zyf-14/LITS-simulation-project/README.md

# LITS Simulation Project




A low-inertia transit system (LITS) built on an autonomous RC car platform. The car follows a black line on the ground using IR sensors, handles intersection triggers, and can be driven manually via keyboard. This repo contains the Raspberry Pi control software, 3D CAD models, and a PC-side video analysis tool.

> **Current status:** the active RC car implementation is in [`rc_car/`](rc_car/) (`track_run.py` + `cycle_server.py`, installed as a systemd service) and the active boom-gate firmware is in [`setup/`](setup/). `src/`, `tools/`, and `simulation/` below are an earlier iteration of the same car, kept for reference — see `archive/` for older experiments. For system architecture, network layout, and the full operating procedure for the LPR car-park demo this project now drives, see the handover documentation supplied alongside this repo.

---

## Folder Structure

```
LITS-simulation-project/
├── src/                  # Raspberry Pi runtime code
│   ├── main.py           # Entry point — runs the line-following loop
│   ├── motor.py          # Servo and DC motor control (GPIO + pigpio)
│   ├── sensor.py         # IR sensor reader (GPIO)
│   ├── flow.py           # Intersection / trigger phase handler
│   ├── config.py         # Vision constants and image processing helpers
│   ├── line_following.py # Frame-level line detection logic
│   ├── camera.py         # Camera interface stub
│   └── picam_trigger.py  # PiCamera2 black-line trigger detector
│
├── tools/                # Standalone calibration and debug utilities
│   ├── calibrate_servo.py    # Interactive servo angle calibration (o/l/r/q keys)
│   ├── test_servo_center.py  # Holds servo at centre position for testing
│   └── manual_drive.py       # WASD keyboard control of motor and servo
│
├── simulation/           # PC-side analysis (no Pi hardware required)
│   └── virtual_test.py   # Replay a recorded video and visualise line-following decisions
│
├── hardware/
│   └── cad/
│       ├── RC Car/           # STL files for chassis, mounts, and panels
│       ├── Boom gate/        # STL files for the boom gate assembly
│       └── Custom Motor driver PCB schematics.pdf
│
├── setup/                # ESP32 firmware for the boom gate (PlatformIO project)
│   ├── src/main.cpp          # Main firmware — FreeRTOS tasks, servo, ultrasonic, Wi-Fi
│   ├── include/
│   │   ├── config.example.h  # Credential template — copy to config.h and fill in
│   │   └── config.h          # Your credentials (gitignored, never committed)
│   └── platformio.ini        # PlatformIO board and library config
│
├── archive/              # Earlier experimental variants (kept for reference)
│
├── requirements.txt
└── .gitignore
```

---

## Hardware

### RC Car
| Component | Detail |
|---|---|
| Platform | RC car chassis with custom 3D-printed body |
| Controller | Raspberry Pi (any model with GPIO) |
| Steering | SG90 servo on GPIO 18 |
| Drive motor | DC motor via L298N-style driver (BIN1=GPIO27, BIN2=GPIO17) |
| Line sensors | 2× IR sensors (LEFT=GPIO22, RIGHT=GPIO25) |
| Camera | Raspberry Pi Camera Module (PiCamera2) |

### Boom Gate
| Component | Detail |
|---|---|
| Controller | ESP32 (DOIT DevKit V1) |
| Gate servo | SG90 on GPIO 13 |
| Distance sensors | 2× HC-SR04 ultrasonic (Sensor 1: TRIG=2, ECHO=5 / Sensor 2: TRIG=18, ECHO=15) |
| Status LED | GPIO 4 |

3D CAD models are in `hardware/cad/`. The full OnShape design is at:
[View OnShape model](https://cad.onshape.com/documents/3a9c78263ff22dc350c29a50/w/96404cf1ed0ead9f22eaefd4/e/8b10ad415629b44db3a26b1b)

---

## Software Setup

### 1. Install dependencies (on the Raspberry Pi)

```bash
pip install -r requirements.txt
sudo pigpiod        # start the pigpio daemon (required at boot)
```

### 2. Run the line follower

```bash
cd src
python main.py
```

Press `Ctrl+C` to stop. GPIO is cleaned up automatically.

### 3. Manual drive (WASD keyboard)

```bash
cd tools
python manual_drive.py
# W = forward, A = left, D = right, S = stop, Ctrl+C = quit
```

### 4. Servo calibration

```bash
cd tools
python calibrate_servo.py
# o = centre, l = left, r = right, q = quit
```

---

## Boom Gate Firmware Setup

The boom gate runs on an ESP32 and is flashed using **PlatformIO** (a VS Code extension — no separate Arduino IDE needed).

### 1. Install PlatformIO

1. Install [VS Code](https://code.visualstudio.com/)
2. Open the Extensions panel (`Ctrl+Shift+X`) and search for **PlatformIO IDE**
3. Install it and restart VS Code

### 2. Configure credentials

```bash
cp setup/include/config.example.h setup/include/config.h
```

Open `config.h` and fill in your Wi-Fi SSID, password, and Pi server IP. This file is gitignored and will never be committed.

### 3. Flash to the ESP32

1. Open the `setup/` folder in VS Code — PlatformIO will detect `platformio.ini` automatically
2. Connect the ESP32 via USB
3. Click the **Upload** button (→ arrow) in the PlatformIO toolbar, or run:

```bash
cd setup
pio run --target upload
```

### 4. Monitor serial output

```bash
cd setup
pio device monitor
```

Or connect via Telnet on port 23 from any device on the same network:
```bash
telnet <ESP32_IP> 23
```

---

## Simulation (PC only)

Replay a recorded run and visualise line-detection decisions frame by frame:

```bash
cd simulation
python virtual_test.py /path/to/recording.mp4
```

Press `q` to quit.

---

## How It Works

1. `sensor.py` reads two IR sensors — each returns `HIGH` on black, `LOW` on white.
2. `main.py` steers left or right depending on which sensor sees the line.
3. When **both** sensors see black (an intersection marker), `flow.py` runs a timed stop-and-turn phase sequence.
4. `motor.py` drives the DC motor with PWM bursts and controls the servo via pigpio pulse widths.

---

## License

MIT — see [LICENSE](LICENSE) for details.
