zyf-14/LITS-simulation-project/hardware/cad/RC Car/RC side car panels.stl

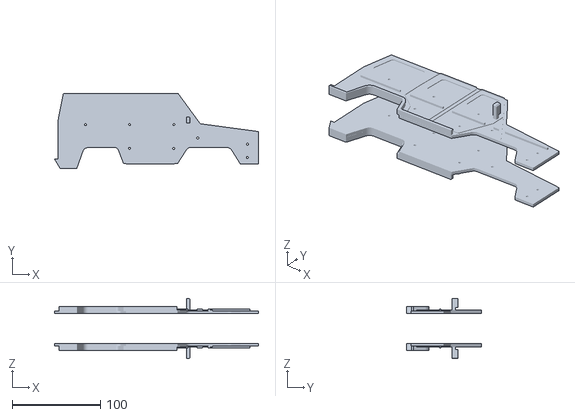
[picture p1: CAD file, 2026-04-12]
hardware/cad/RC Car/RC side car panels.stl
230.8 x 84.5 x 68.0
