zyf-14/LITS-simulation-project/hardware/cad/RC Car/RC body frames.stl

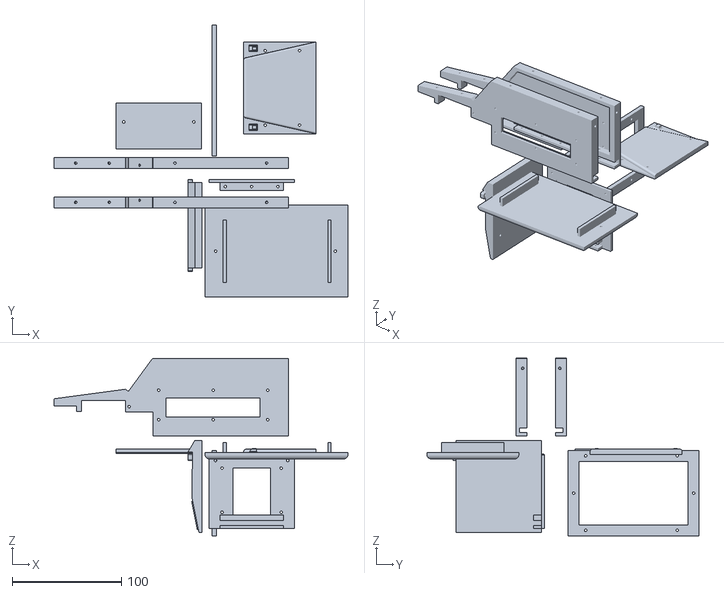
[picture p2: CAD file, 2026-04-12]
hardware/cad/RC Car/RC body frames.stl
269.5 x 249.5 x 162.7
