zyf-14/LITS-simulation-project/hardware/cad/RC Car/Pi camera holder + Grill cover.stl

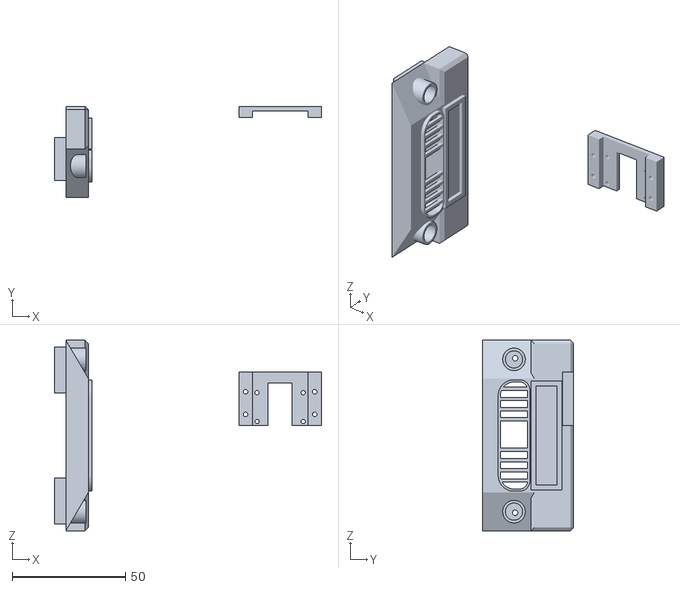
[picture p3: CAD file, 2026-04-12]
hardware/cad/RC Car/Pi camera holder + Grill cover.stl
118.0 x 40.4 x 84.3
