zyf-14/LITS-simulation-project/hardware/cad/RC Car/RC car base.stl

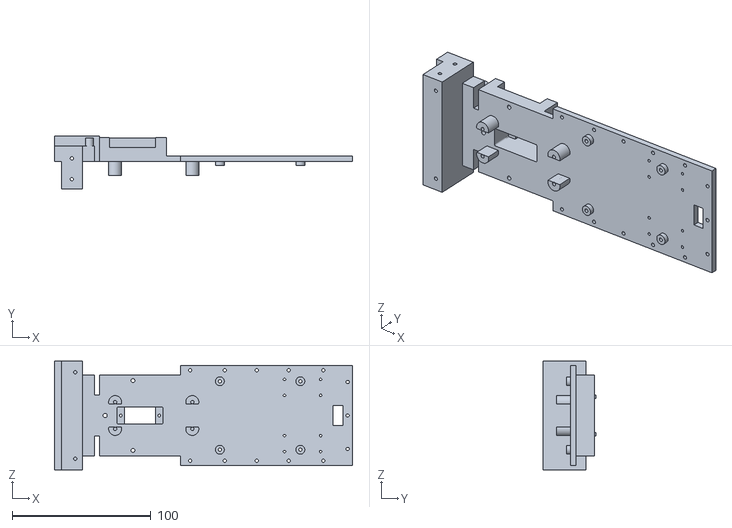
[picture p4: CAD file, 2026-04-12]
hardware/cad/RC Car/RC car base.stl
214.7 x 38.5 x 78.2
