zyf-14/LITS-simulation-project/hardware/cad/RC Car/Steering mechanism.stl

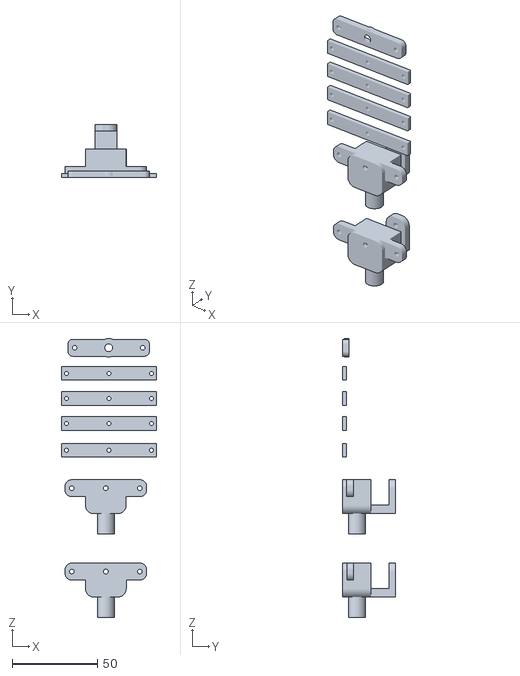
[picture p5: CAD file, 2026-04-12]
hardware/cad/RC Car/Steering mechanism.stl
56.1 x 31.4 x 164.0
