zyf-14/LITS-simulation-project/hardware/cad/RC Car/Arduino motor holder.stl

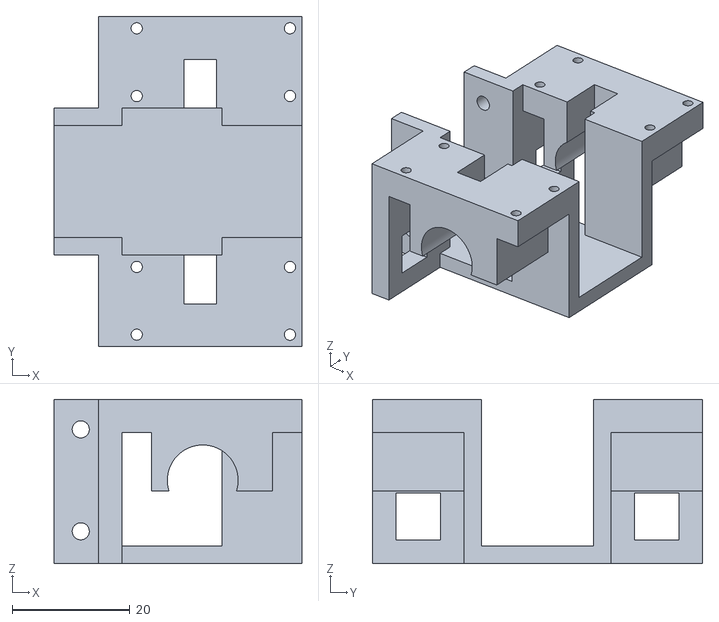
[picture p6: CAD file, 2026-04-12]
hardware/cad/RC Car/Arduino motor holder.stl
42.0 x 56.0 x 27.9
