zyf-14/LITS-simulation-project/hardware/cad/Custom Motor driver PCB schematics.pdf

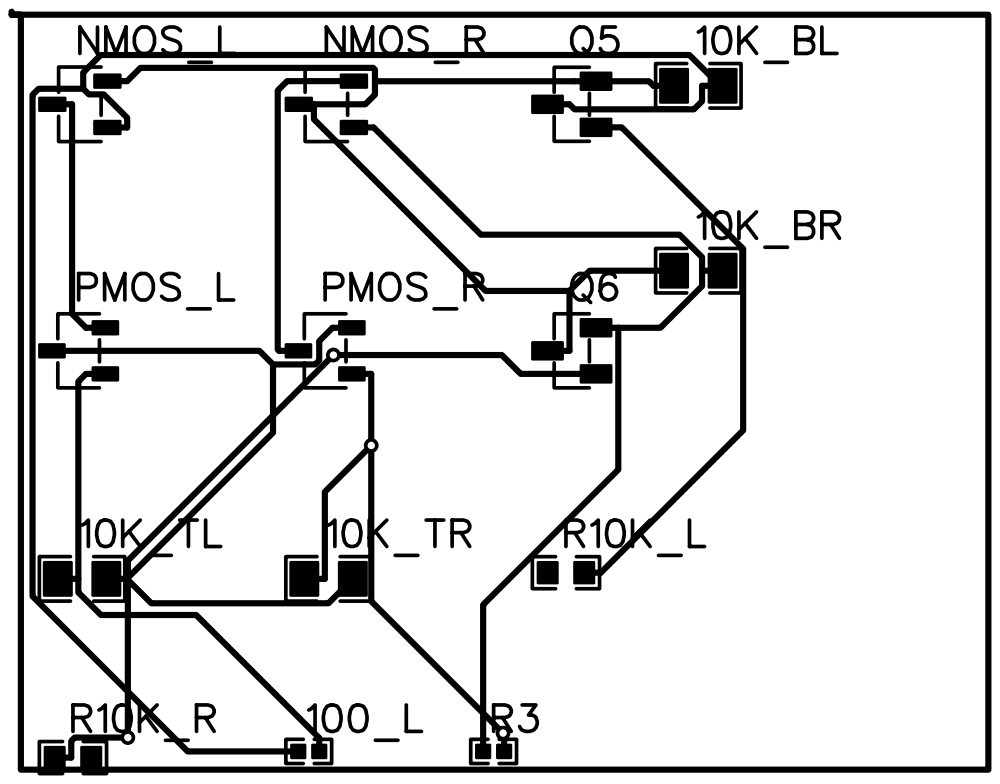
[picture p7: page 1]
