zyf-14/LITS-simulation-project/rc_car/camera.py

# === camera.py ===

# Dummy function — always returns True for testing
def sees_black_object():
    # Replace this with actual OpenCV logic later
    return False  # Return True to simulate obstacle, False to simulate clear path
