zyf-14/LITS-simulation-project/setup/include/config.example.h

#ifndef CONFIG_H
#define CONFIG_H

// Copy this file to config.h (gitignored) and fill in real values.
// config.h is never committed - see .gitignore.

constexpr char WIFI_SSID[]     = "your-ssid";
constexpr char WIFI_PASSWORD[] = "your-password";

#endif
