zyf-14/LITS-simulation-project/(commit log)

2025-07-08 Drawing a vertical line across the center of every frame that acts as a centerpoint
2026-04-12 Updated CAD link
2026-04-12 Uploaded schematic for custom motor driver
2026-04-12 Arduino motor holder
    [Arduino motor holder.stl]
2026-04-12 Added Steering mechanism
    [Steering mechanism.stl]
2026-06-16 Reorganise repo into clean professional structure
    [Arduino motor holder.stl, Pi camera holder + Grill cover.stl, RC body frames.stl, RC car base.stl, RC side car panels.stl, Steering mechanism.stl]
2026-06-16 Add boom gate ESP32 firmware in setup/
    - Add setup/src/main.cpp: polished FreeRTOS firmware for ESP32 boom gate
    - Add setup/include/config.example.h: credential template (config.h is gitignored)
    - Add setup/platformio.ini: PlatformIO build config for ESP32 DevKit V1
    - Remove hardcoded WiFi credentials and Pi login password from source
    - Update .gitignore to exclude setup/include/config.h and PlatformIO build output
    - Update README: add boom gate hardware table, PlatformIO setup instructions
2026-08-14 ESP32 boom-gate firmware: WiFi HTTP server, dual ultrasonic presence interlock, static IP, servo calibration endpoint
    FreeRTOS-based firmware (PlatformIO, esp32dev/Arduino) driving the boom
    gate's servo and both entry/exit ultrasonic sensors, serving /open_gate,
    /close_gate, /status, /set_angle over WiFi with a static IP. Presence
    interlock refuses to close on the vehicle; both sensors debounce
    threshold-flicker and pulseIn-timeout dropouts separately so a bad
    reading can't be mistaken for the vehicle actually clearing. WiFi
    credentials live in a gitignored include/config.h (see
    include/config.example.h for the template).
    [config.example.h, main.cpp, main.h]
2026-08-14 Remove stale ESP32 firmware stub, replaced by boomgate_module merge
    [config.example.h, main.cpp]
2026-08-15 Initial commit: RC car line-follower + multi-checkpoint track runner
    Core files:
    - motor.py/sensor.py - low-level GPIO motor + IR line sensor control
    - main.py - simple continuous line-following loop
    - track_run.py - full track cycle (HOME -> gate -> wall -> return),
    integrated with the real ESP32 boom-gate/LPR pipeline
    - reset_to_home.py - reverse-only recovery from a denied re-entry
    - cycle_server.py - HTTP control server so the monitoring webpage can
    start/reset a cycle and poll status remotely
    [calibrate.py, calibrate_rc.py, camera.py, center.py, checkpoint_run.py, cycle_server.py, flow.py, main-bert.py]
2026-08-19 Shorten reverse-past-home overshoot from 5s to 3s
    5s was carrying the car further past HOME than needed on the
    reverse leg, verified against live runs.
    [track_run.py]
2026-08-19 Squashed 'setup/' changes from 796d92d..68a84b5
    68a84b5 setup/: sync firmware through a1d9500 (2026-08-19 handover)
    REVERT: 796d92d ESP32 boom-gate firmware: WiFi HTTP server, dual ultrasonic presence interlock, static IP, servo calibration endpoint
    git-subtree-dir: setup
    git-subtree-split: 68a84b5584b7509801db5341a5c3d014975c24e6
    [main.cpp, main.h]
2026-08-19 Point README at the active rc_car/ + setup/ implementation, add LICENSE
    The badge already claimed MIT but no LICENSE file existed. The Folder
    Structure section still described the pre-rc_car layout as current,
    which no longer matches what actually runs the demo.
